rice-eclipse/rice-eclipse-mk1-1/README.md

# rice-eclipse-mk1-1
The official repository for mark 1.1 code and pcb schematics for the Rice Eclipse Rocketry Club at Rice University.
