rice-eclipse/rice-eclipse-mk1-1/(threads)

Thread 1 (2017-08-24):

Images For Wiki

rjcrjc, 2017-08-24:
This is an empty issue that contains images used in the wiki.

luke-avionics, 2017-09-16:
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

Ignition system

luke-avionics, 2017-09-16:
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

Ignition system (without alarm battery)

Closed 2017-09-02.

Thread 3 (2017-09-02):

Design Solenoid Driver

rjcrjc, 2017-09-02:
Build and test a circuit that switches on and off the solenoids for the ball valves. The output must be +12V and the inputs must have 3.3V logic level.  Get a breadboard setup and then add eagle files.
Suggest using mosfets or op amps.

rjcrjc, 2017-09-07:
@patrick-han is working on this

rjcrjc, 2017-09-09:
Circuit built and tested.

Closed 2017-09-09.

Thread 4 (2017-09-02):

Finish Power Regulation

rjcrjc, 2017-09-02:
Add regulators for +10V and -0.23V from the parts listed on the master parts list and then add them to the schematic.

I do not intend for this to be taken as a full project and I am using it mostly as a simple issue to test things for our github project management platform.

Closed 2017-12-17.

Thread 5 (2017-09-02):

Test and Implement Load Cell Amplification

rjcrjc, 2017-09-02:
We need to amplify data from the load cells from ~1-20mV to 3.3V in order to sample it.  This must have configurable gain and a configurable zero (using a screw/potentiometer that we could turn on the board). The op amps we will use are probably already selected and we have a test setup for them, but we need to verify it works with the load cell.

Level shifting circuitry may also be needed, which is annoying.

Once tested add it to the schematic on eagle.

rjcrjc, 2017-09-07:
There is a test board that works very well in the oedk right now. The downside is that it doesn't have any level shifting circuitry and I think we're running close to the amplification that we can reasonably use without doubling up op amps (we shouldn't aim for gain above 1500, which is what's currently on the board). If we get level shifting working, then we can gain a factor of 3 for amplification, which is probably about what we need. Let me know if you want me to walk you through what we currently have, because I can.

Closed 2017-10-16.

Thread 6 (2017-09-02):

Design Ignition Relay Driver

rjcrjc, 2017-09-02:
Similar to solenoid driver. We need to switch a +12V output from a 3.3V logic level pin on the raspberry pi.

Build a test circuit with the relay and then add to schematics.

rjcrjc, 2017-09-07:
@patrick-han is working on this

rjcrjc, 2017-09-09:
Test circuit built and tested.

Closed 2017-09-09.

Thread 11 (2017-09-03):

DMA for SPI driver on raspberry pi

rjcrjc, 2017-09-03:
It seems that most SPI libraries do not offer DMA. We need to fix this if we want good performance, look into whether any exist and test it. If not let me know and I will help look into other alternatives.

Thread 13 (2017-09-03):

Make Raspberry Pi act like Real Time Device

rjcrjc, 2017-09-03:
In general it is hard to make the raspberry pi act like it has a Real Time Operating System (RTOS), especially with common OS like Raspbian. It seems that there are some kernel options that may help this cause. In general we need to find a configuration that minimizes any interruptions from the operation of the system while still supporting networking, which we need to communicate with the base station computer.

I found [this link](http://www.frank-durr.de/?p=203) which may be of use.

I suspect this is a very difficult project and we may be better off switching away from the Raspberry pi in the long term instead of tackling this beast.

Thread 14 (2017-09-03):

Develop ADC test code

rjcrjc, 2017-09-03:
Build the ADC on a breadboard and test basic sampling to see if it works as expected.

Ideally this would include some functions we could run that would handle this and some pin definitions in a separate file to allow for portability later.

XtLiu, 2017-09-04:
I'll try to work on this part. Anyone interested is welcome to join me :)

Closed 2017-10-16.

Thread 16 (2017-09-03):

Figure out communication between pi and base station

rjcrjc, 2017-09-03:
Develop code for sending data between pi and base station.

This is some tricky networking code that may require running in its own thread. Contact me for advice because I think it will be difficult for anyone who hasn't taken Comp 321 or is willing to do a lot of research.

rjcrjc, 2017-09-08:
I got some basics working using socket and listener. Look at the echo_server branch and build target for examples. This basically covers reading bytes from the user, however it's unbuffered which means that it's going to be very slow. Whoever continues work on this should use buffered inputs.

Closed 2017-12-17.

Thread 7 (2017-09-03):

Figure out connectors for the PCB to the raspberry pi.

rjcrjc, 2017-09-03:
Find a connector we can use to connect the raspberry pi GPIO pins and other things to the PCB. I suggest using a ribbon cable for GPIO and for the other stuff, I'm not sure.

rjcrjc, 2017-09-07:
Got the GPIO connectors dealt with. Still need to add 2x20 thru hole connector to board + some screw holes for a holder for the idc cable. See parts list for details.

The other important thing is that power for the raspberry pi should be figured out. I think the best bet is just to take this from the mk2.

Closed 2017-09-14.

Thread 8 (2017-09-03):

Select Connectors for the Mk1-1 Box

rjcrjc, 2017-09-03:
Find connectors that we will plug into the exterior of the box. This is more of a long-term issue that doesn't directly correspond to code or work on the PCB, but it should be done.

Closed 2017-12-17.

Thread 9 (2017-09-03):

Ignition Current and Voltage Measurement

rjcrjc, 2017-09-03:
Design a system that tracks the current through and voltage across the igniter during ignition so that we can measure the electrical properties of the igniters.

This is a low-priority issue, worry about it later.

Thread 37 (2017-10-16):

Add support to ADC code for multiple ADCs.

rjcrjc, 2017-10-16:
## ToDo
- Currently the ADC code is set to always use chip select 0.
- This will not work for us because we would like to support 3+ ADCs and we only have two chip select pins on the pi.
- This means that we will need to manually control the chip select pins.
- Write a simple test example that switches between multiple ADCs. We don't need to actually connect ADCs to the pi to test this. I just want to see that the chip select pins change in accordance with the desired ADC.
- Verify this in particular with the dedicated chip select pins because it might be that we cannot control them independently and must do some extra work to deal with that.

## Useful Advice
- Take a look at the [SPI settings](http://www.airspayce.com/mikem/bcm2835/group__spi.html#ga2fa186568605c21e9166a19b1d82ea95) in the  [BCM2835](http://www.airspayce.com/mikem/bcm2835/) library header documentation.
- Also useful [list of constants](http://www.airspayce.com/mikem/bcm2835/group__constants.html) with some docs.
- Any constants we should be using should be passing to the adc should be of the type RPiGPIOPin and should be from the grouping RPI_V2_* because that's what our pi is (correct me if I'm wrong here)
- Take a look at the blink example on the library for controlling GPIO pins.
- It's possible that the pin state won't change immediately when you call the pin write function (unlikely, but I'm not sure. Check library docs to verify). Make sure that you don't do any SPI work until this happens.

rjcrjc, 2017-10-21:
[This](http://ww1.microchip.com/downloads/en/DeviceDoc/21298e.pdf) is the datasheet for the adc.

Closed 2017-12-17.

Thread 38 (2017-10-16):

Investigate ADC Drift and Noise

rjcrjc, 2017-10-16:
## Background
- The ADC test circuit on the breadboard is susceptible to noise and drift.
- It is significantly worse than performance promised in the [datasheet](http://ww1.microchip.com/downloads/en/DeviceDoc/21298e.pdf).
- Much of this is likely due to breadboard, but it's not clear how much.
- Most of the code to control the ADC already exists and is likely not at fault.

## ToDo
- Measure the voltage on the ADC pins using oscilloscope and see if it gives odd results when compared with the readings.
### Investigate the issues with drift.
- It's possible that the drift is coming from the ADC reading from high impedance values because most drift occurs when we switch what's connected to the pin. In this case we want to observe the issues in something more like our use case.
- Observe drift when switching which pin the adc is reading from (for instance read from each of the eight channels sequentially)
- Observe drift when all channels are connected to a low impedance input (like directly connected to +3.3V or GND).
- Is drift worse when we're using differential inputs?
### Investigate noise in the inputs:
- Variance, Max, Min value we read when conencted to an input like the potentiometer.
- Note that adc performs much better when reading from low impedance inputs. Try using an op amp follower circuit to see if this helps when using potentiometer.
- May be worth lowering the clock rate when reading to see if this also helps with noise.
    - [SPI clock rate](http://www.airspayce.com/mikem/bcm2835/group__spi.html#gad623657d9513faa89d22ae1dc87eec38) can be lowered by raising the clock divider in our [the adc block library](software/src/adc/adc_block.cpp)

## Useful Information
- You don't need to read entire datasheet. Skim it for things that look relevant.
- See if the datasheet mentions if clock rate affects noise.
- It's possible that some primitive antialiasing will improve performance (like a 10K resistor in series with a 10nF capacitor between the input channel and ground for single channel inputs (intuitively this acts like a RC filter with a cutoff of 10kHz). For dual channel the RC goes between the two inputs and is not connected to ground.
- If you have a ton of extra time, it might be interesting to try soldering the extra ADC we have in the Digital ICs drawer to a simple custom PCB and see if the noise problems go away.
- It's very possible that only the ground input has major issues when reading. If that's the case you don't necessarily need to solve it. But it's worth checking if an op amp that's outputting ~0V has the same problem.

Thread 49 (2017-12-17):

Gracefully handle error when PI server cannot send header instead of terminating.

rjcrjc, 2017-12-17:
If the socket breaks during a header write the server code terminates. We must fix this.

Thread 50 (2017-12-17):

Determine why GUI message length assertion errors are getting triggered

rjcrjc, 2017-12-17:
Two possible causes:
* the actual message size sent by the PI are the wrong length, which could happen if a message splits across the circular buffer.
    * This can be tested by downsizing circular buffer and seeing if it happens more often.
* The GUI is getting short reads and not handling the short reads correctly.
    * Best way to test this is to have some assertion that we're not having short reads.

Both of these might be best resolved by switching the message sending to UDP, but we should still figure out why this is failing with TCP.

Thread 51 (2017-12-17):

Add High Pressure Shutoff for Ignition in RPI Code.

rjcrjc, 2017-12-17:
Add code to check that the pressure is not too high in the combustion chamber (? Ask, since it might be a different PT we need to read) and if the pressure is too high, then terminate the burn.

Note that we do not have support for actual pressure values at the moment, so for now: have a value that is hardcoded and we'll figure out a way to properly evaluate the pressure later.

Ideally, this will use a moving average of the pressure data to remove high frequency noise.

Thread 52 (2017-12-17):

Add Logging of Collected Data to Raspberry PI

rjcrjc, 2017-12-17:
Create Log files for each ADC and write the data to logs so that the data collection is more resilient to GUI crashes.

Thread 53 (2017-12-17):

Improve the look of the GUI

rjcrjc, 2017-12-17:
The final changes to the GUI were made with no understanding of Tkinter and the GUI looks terrible. Make the GUI usable and also make the positions somewhat dependent on the size of the window. That is, the buttons should still show up even if the window is resized to be relatively small.

Ideally, we would also have tabs for different data displays.

ty19, 2017-12-22:
The GUI (pushed to final-code-c) looks nicer now, imo. The right panel is ugly because it's mostly empty, but we can always add things later. I set the window to be non-resizable, which I consider a fix to the window size issue.

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
 It seems like there's a built-in way to do tabs, but I'm not sure what I would put in each one. We could do something like default (important ones we look at during tests), LCs, PTs, TCs for each tab. Do you have something specific in mind?

rjcrjc, 2017-12-24:
I did not have anything specific in mind for tabs, but I have a couple things that should probably go in their own tabs: Namely a tab for any output from the loggers. I would also have a tab for each sensor that includes calibration and some data such as an average over last 10 seconds.

I suppose the window resizing fix is probably the easiest thing without a lot of tkinter work that isn't really a good use of our time.

Thread 54 (2017-12-17):

Fix real-time graphing.

rjcrjc, 2017-12-17:
The graphs on the GUI do not discard old data and they also display the data with all data-points. Furthermore, they do not look good with noisy data.

The graphs should have the following two properties:
* Ability to display a specified range of time (say 10 seconds, 1 minute etc.)
    * For large times like a minute or more, the graphing code will need to downsample the data in order to avoid plotting too many points. Contact me for help with proper downsampling and decimation.
* Option for denoised plots. Again contact me or look at the analytics.m script I posted in the google drive for how to clean up the noise.

ty19, 2017-12-22:
I added a basic way to change time ranges. I guess time would just be total_samples / samples_per_time if we put the sample rate of each sensor somewhere in the code. I can add buttons and stuff so we can change the time ranges during tests. Not sure on how to downsample other than by throwing out every nth data point in the data we're plotting.

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

Is there any reason denoised plots would not be the default option?

rjcrjc, 2017-12-24:
Nice work on this stuff! I can help with proper denoising and downsampling later since it's not really in the realm of CS knowledge, but for now just throwing out points is good enough for the real-time plots.

Thread 56 (2017-12-17):

Improve the python translation of C Structs.

rjcrjc, 2017-12-17:
The python code currently uses hardcoded sizes to read from C structs, which is bad because it is tedious and error-prone when writing. There are libraries for translating sizes from c structs, which is what we need when sending the data formatted using C Structs.

Thread 57 (2017-12-17):

Make Code Resilient to Crashes

rjcrjc, 2017-12-17:
When the raspberry pi code crashes, the code should be restarted immediately to resume logging.

The easiest way to do this is to run the server through a shell script that restarts when the PI returns and terminates if killed manually or maybe if the PI code returns a specific value.

While this is not a good solution to crashes, it does mean that less data is missed if the code does crash.

Thread 58 (2017-12-17):

Figure out what is wrong with the Pressure Transducer circuits

rjcrjc, 2017-12-17:
The pressure transducer circuits do not read properly in the range of 0 to 1200PSI at the moment. There are several main causes right now:
* We changed the gain resistor in line with the pressure transducer to fix the issue the night before the test.
* The gain on the circuits themselves is wrong and slightly inconsistent.

* Maybe:
    * The bypass capicitor on the op amps is too small.
    * The circuit was designed with wrong parameters measured because the PT is senstitive to installation method.
### To consider:
* At the moment two of the circuits behave differently from the leftmost one. Not sure why.
* Increase sample rate and verify readings are still fine (probably easy).
* Note that doing this well will probably require pulling the board out, which sucks.
