rice-eclipse/rice-eclipse-mk1-1/eagle/rice-eclipse-mk-1-1-side/rice-eclipse-mk-1-1-side/sideboard.brd

## EAGLE design eagle/rice-eclipse-mk-1-1-side/rice-eclipse-mk-1-1-side/sideboard.brd (2018-01-20)

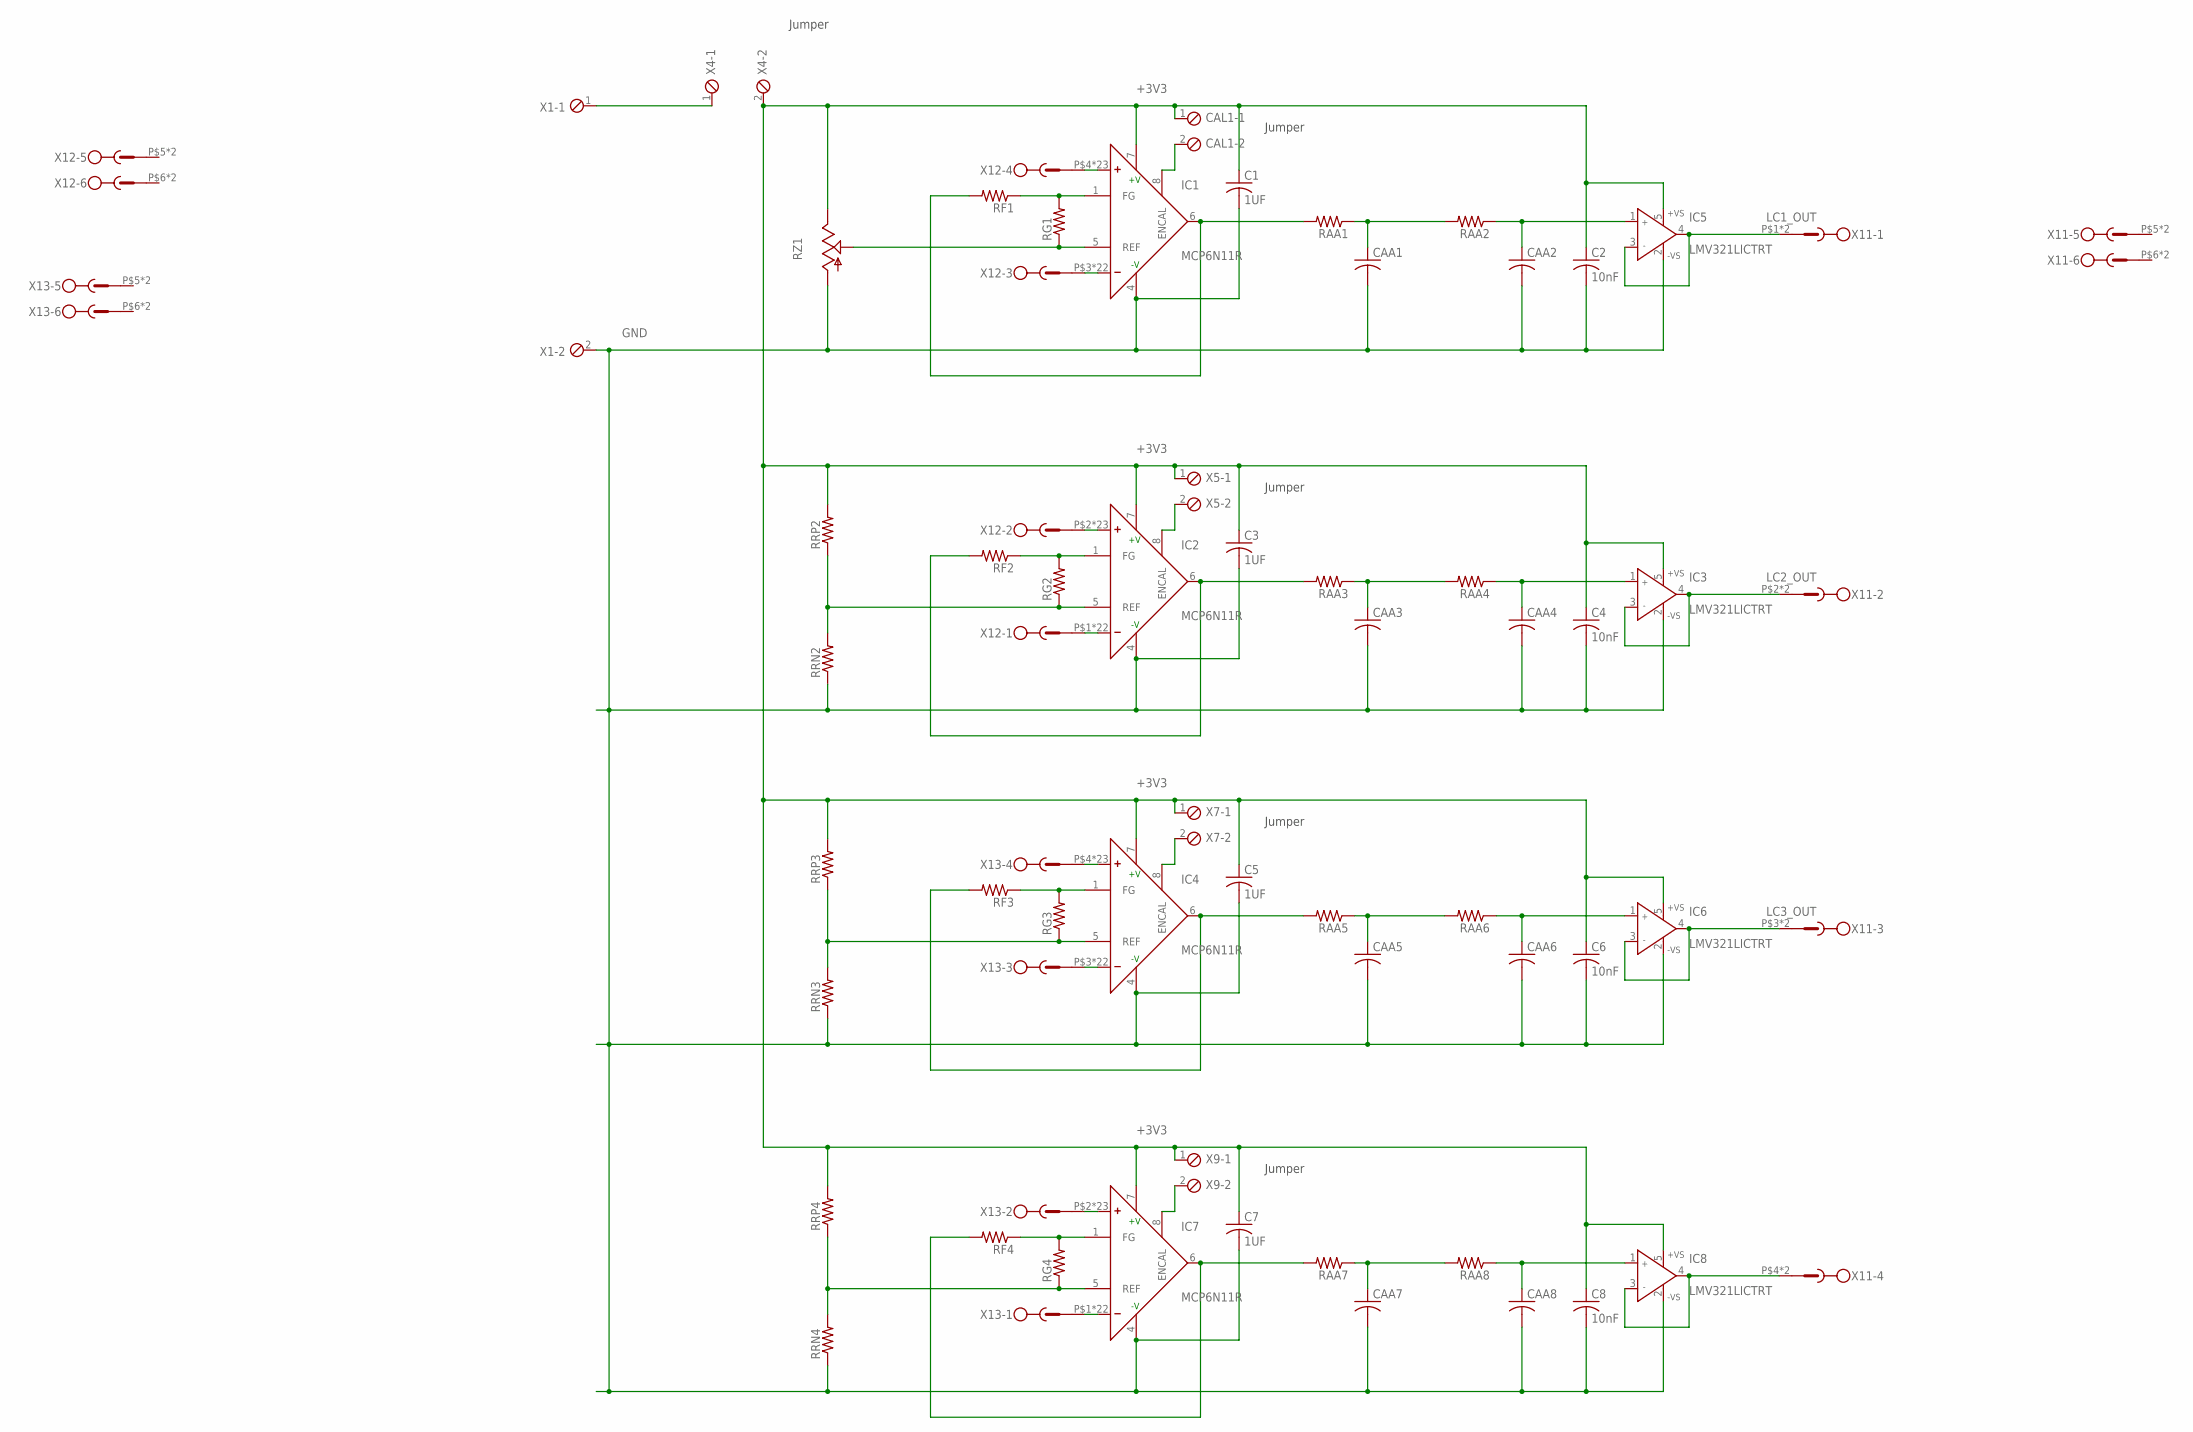
[picture p1: schematic sideboard.sch, <b>LC Sideboard</b><br> A small board used to amplify and t…]

Parts:
C1, C3, C5, C7: 1UF; C0603
C2, C4, C6, C8: 10nF; C0603
CAA1, CAA2, CAA3, CAA4, CAA5, CAA6, CAA7, CAA8: C-US025-025X050; C025-025X050
CAL1: MPT2; 2POL254
IC1, IC2, IC4, IC7: MCP6N11R; SO-8
IC3, IC5, IC6, IC8: LMV321LICTRT; SOT23-5
RAA1, RAA2, RAA3, RAA4, RAA5, RAA6, RAA7, RAA8: R-US_0204/7; 0204/7
RF1, RF2, RF3, RF4: R-US_0204/7; 0204/7
RG1, RG2, RG3, RG4: R-US_0204/7; 0204/7
RRN2, RRN3, RRN4: R-US_R0805; R0805
RRP2, RRP3, RRP4: R-US_R0805; R0805
RZ1: TRIM_US-S64W; S64W
X1, X4, X5, X7, X9: MPT2; 2POL254
X11, X12, X13: 1770924

Connections:
+3V3: C1.1, C2.1, C3.1, C4.1, C5.1, C6.1, C7.1, C8.1, CAL1.1, IC1.7 (+V), IC2.7 (+V), IC3.5 (+VS), IC4.7 (+V), IC5.5 (+VS), IC6.5 (+VS), IC7.7 (+V), IC8.5 (+VS), RRP2.2, RRP3.2, RRP4.2, RZ1.E, X4.2, X5.1, X7.1, X9.1
GND: C1.2, C2.2, C3.2, C4.2, C5.2, C6.2, C7.2, C8.2, CAA1.2, CAA2.2, CAA3.2, CAA4.2, CAA5.2, CAA6.2, CAA7.2, CAA8.2, IC1.4 (-V), IC2.4 (-V), IC3.2 (-VS), IC4.4 (-V), IC5.2 (-VS), IC6.2 (-VS), IC7.4 (-V), IC8.2 (-VS), RRN2.1, RRN3.1, RRN4.1, RZ1.A, X1.2
LC1_OUT: IC5.3 (IN-), IC5.4 (OUT), X11.P$1, X11.P$7
LC2_OUT: IC3.3 (IN-), IC3.4 (OUT), X11.P$2, X11.P$8
LC3_OUT: IC6.3 (IN-), IC6.4 (OUT), X11.P$3, X11.P$9
LC4_OUT1: IC8.3 (IN-), IC8.4 (OUT), X11.P$4, X11.P$10
unnamed: IC2.3 (+), X12.P$2, X12.P$8
unnamed: IC2.2 (-), X12.P$1, X12.P$7
unnamed: X1.1, X4.1
unnamed: IC1.6 (OUT), RAA1.2, RF1.2
unnamed: CAL1.2, IC1.8 (ENCAL)
unnamed: CAA1.1, RAA1.1, RAA2.2
unnamed: IC1.1 (FG), RF1.1, RG1.2
unnamed: IC1.5 (REF), RG1.1, RZ1.S
unnamed: CAA2.1, IC5.1 (IN+), RAA2.1
unnamed: IC1.2 (-), X12.P$3, X12.P$9
unnamed: IC1.3 (+), X12.P$4, X12.P$10
unnamed: IC2.8 (ENCAL), X5.2
unnamed: IC2.6 (OUT), RAA3.2, RF2.2
unnamed: IC2.1 (FG), RF2.1, RG2.2
unnamed: CAA3.1, RAA3.1, RAA4.2
unnamed: CAA4.1, IC3.1 (IN+), RAA4.1
unnamed: IC2.5 (REF), RG2.1, RRN2.2, RRP2.1
unnamed: IC7.2 (-), X13.P$1, X13.P$7
unnamed: IC7.3 (+), X13.P$2, X13.P$8
unnamed: IC4.8 (ENCAL), X7.2
unnamed: IC4.6 (OUT), RAA5.2, RF3.2
unnamed: IC4.1 (FG), RF3.1, RG3.2
unnamed: CAA5.1, RAA5.1, RAA6.2
unnamed: CAA6.1, IC6.1 (IN+), RAA6.1
unnamed: IC4.5 (REF), RG3.1, RRN3.2, RRP3.1
unnamed: IC4.3 (+), X13.P$4, X13.P$10
unnamed: IC4.2 (-), X13.P$3, X13.P$9
unnamed: IC7.8 (ENCAL), X9.2
unnamed: IC7.6 (OUT), RAA7.2, RF4.2
unnamed: IC7.1 (FG), RF4.1, RG4.2
unnamed: CAA7.1, RAA7.1, RAA8.2
unnamed: CAA8.1, IC8.1 (IN+), RAA8.1
unnamed: IC7.5 (REF), RG4.1, RRN4.2, RRP4.1

Notes on the sheet:
Jumper

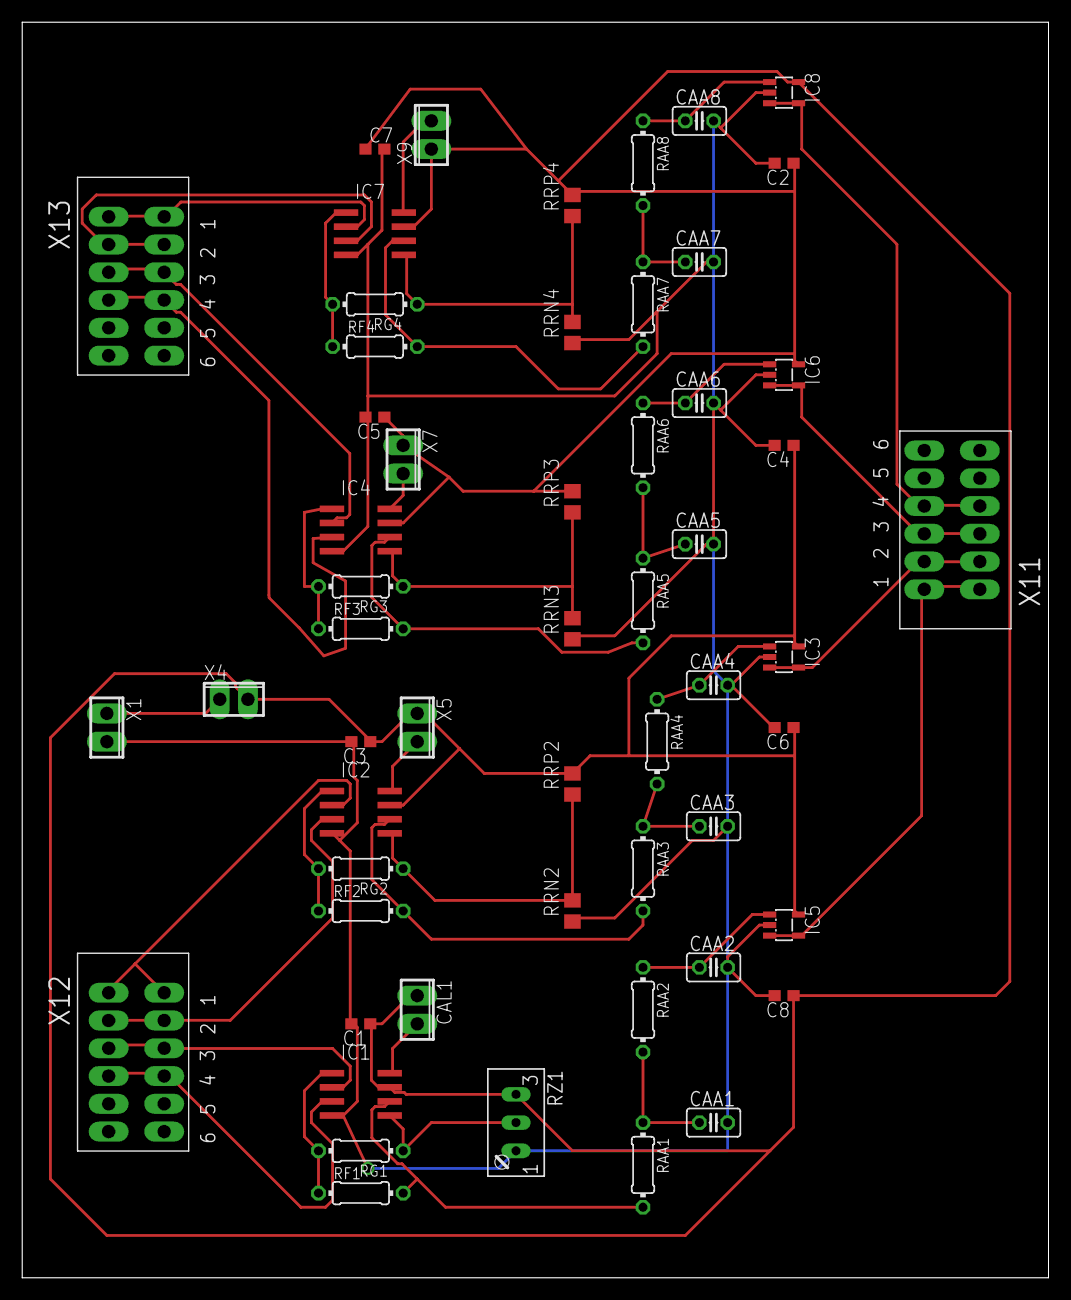
[picture p2: board sideboard.brd from above]

Board: 2 copper layers, 92.4 x 113.0 mm, 56 parts (0 on the bottom side), 39 nets.
