rice-eclipse/rice-eclipse-mk1-1/eagle/rice-eclipse-mk-1-1/main.brd

## EAGLE design eagle/rice-eclipse-mk-1-1/main.brd (2017-11-11)

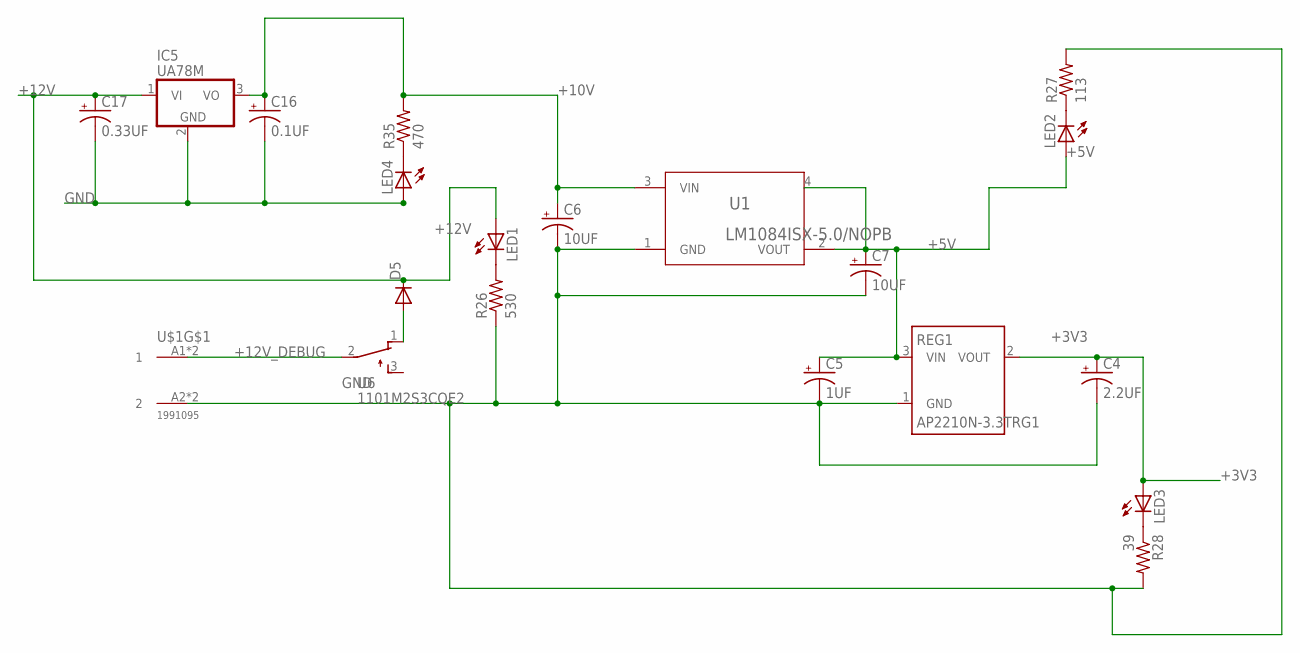
[picture p3: schematic main.sch, sheet 1, <b>Power Regulation</b><br> A sheet for all the voltage reg…]

Parts:
C4: 2.2UF; E2,5-5
C5: 1UF; E2,5-5
C6, C7: 10UF; E2,5-5
C16: 0.1UF; E2,5-5
C17: 0.33UF; E2,5-5
D5: DIODE-DO201-15; DO201-15
IC5: UA78M; TO220S
LED1, LED2, LED3, LED4: LED5MM
R26: 530; R0603
R27: 113; R0603
R28: 39; R0603
R35: 470; R0603
REG1: AP2210N-3.3TRG1; SOT23
U1: LM1084ISX-5.0/NOPB; TS3B
U6: 1101M2S3CQE2
U$1: 1991095

Connections:
+3V3: C4.+, LED3.A, REG1.2 (VOUT); also elsewhere on the board
+5V: C5.+, C7.+, LED2.A, REG1.3 (VIN), U1.2 (VOUT), U1.4; also elsewhere on the board
+10V: C6.+, C16.+, IC5.3 (VO), R35.2, U1.3 (VIN); also elsewhere on the board
+12V: C17.+, D5.C, IC5.1 (VI), LED1.A; also elsewhere on the board
+12V_DEBUG: U6.2, U$1.A1 (1), U$1.B1 (1)
GND: C4.-, C5.-, C6.-, C7.-, C16.-, C17.-, IC5.2 (GND), LED4.A, R26.1, R27.2, R28.2, REG1.1 (GND), U1.1 (GND), U$1.A2 (2), U$1.B2 (2); also elsewhere on the board
unnamed: LED1.K (C), R26.2
unnamed: LED2.K (C), R27.1
unnamed: LED3.K (C), R28.1
unnamed: D5.A, U6.1 (O)
unnamed: LED4.K (C), R35.1

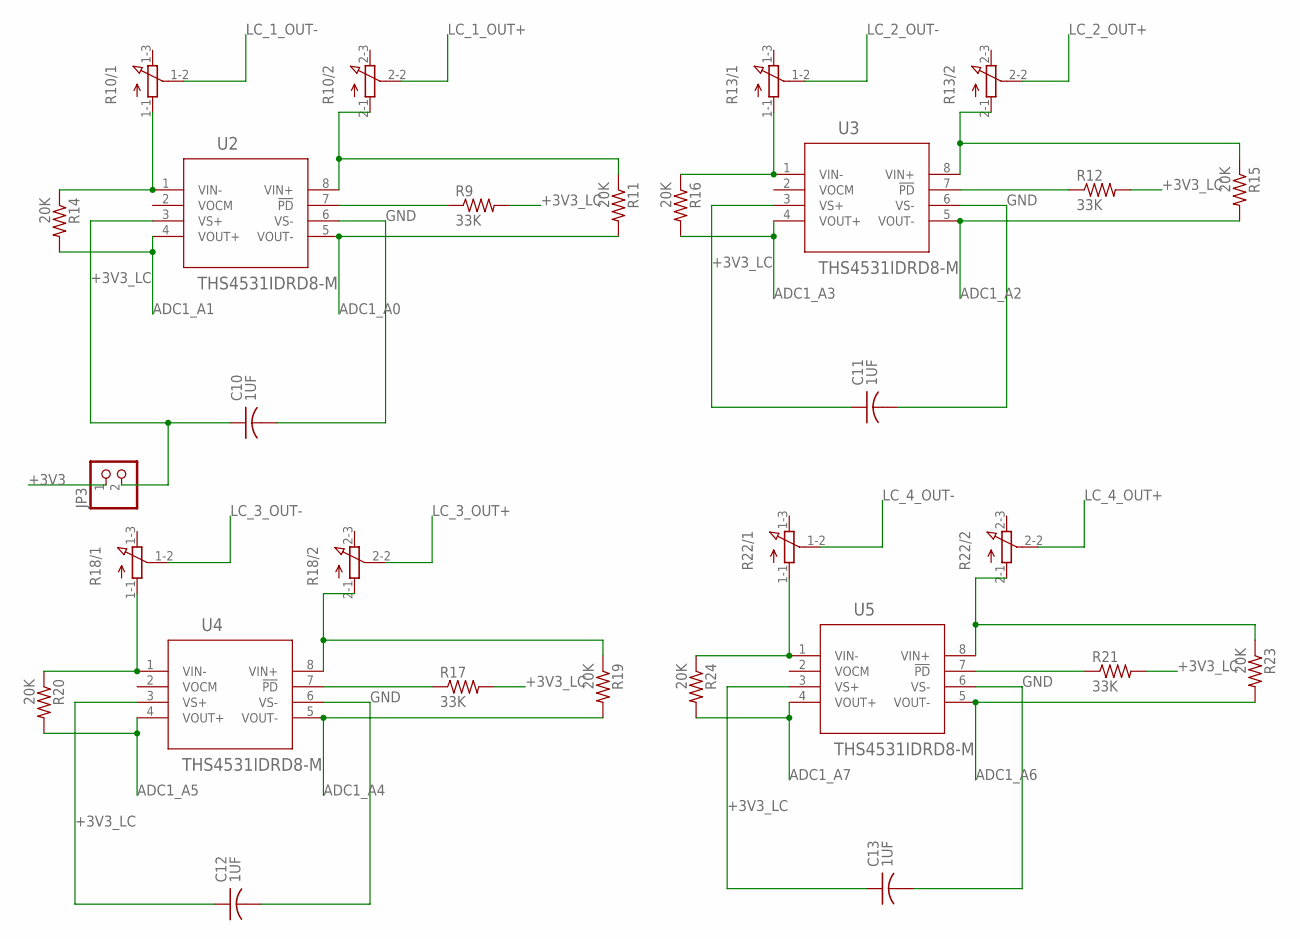
[picture p4: schematic main.sch, sheet 2, <b>Load Cell Amplification</b><br> A schematic for amplifyi…]

Parts:
C10, C11, C12, C13: 1UF; C0603
JP3: PINHD-1X2; 1X02
R9, R12, R17, R21: 33K; R0603
R10, R13, R18, R22: PTD902
R11, R14, R15, R16, R19, R20, R23, R24: 20K; R0603
U2, U3, U4, U5: THS4531IDRD8-M; D8-M

Connections:
+3V3: JP3.1; also elsewhere on the board
+3V3_LC: C10.1, C11.1, C12.1, C13.1, JP3.2, R9.2, R12.2, R17.2, R21.2, U2.3 (VS+), U3.3 (VS+), U4.3 (VS+), U5.3 (VS+)
ADC1_A0: R11.2, U2.5 (VOUT-); also elsewhere on the board
ADC1_A1: R14.2, U2.4 (VOUT+); also elsewhere on the board
ADC1_A2: R15.2, U3.5 (VOUT-); also elsewhere on the board
ADC1_A3: R16.2, U3.4 (VOUT+); also elsewhere on the board
ADC1_A4: R19.2, U4.5 (VOUT-); also elsewhere on the board
ADC1_A5: R20.2, U4.4 (VOUT+); also elsewhere on the board
ADC1_A6: R23.2, U5.5 (VOUT-); also elsewhere on the board
ADC1_A7: R24.2, U5.4 (VOUT+); also elsewhere on the board
GND: C10.2, C11.2, C12.2, C13.2, U2.6 (VS-), U3.6 (VS-), U4.6 (VS-), U5.6 (VS-); also elsewhere on the board
LC_1_OUT+: R10.2-2 (S); also elsewhere on the board
LC_1_OUT-: R10.1-2 (S); also elsewhere on the board
LC_2_OUT+: R13.2-2 (S); also elsewhere on the board
LC_2_OUT-: R13.1-2 (S); also elsewhere on the board
LC_3_OUT+: R18.2-2 (S); also elsewhere on the board
LC_3_OUT-: R18.1-2 (S); also elsewhere on the board
LC_4_OUT+: R22.2-2 (S); also elsewhere on the board
LC_4_OUT-: R22.1-2 (S); also elsewhere on the board
unnamed: R9.1, U2.7 (!PD)
unnamed: R10.2-1 (A), R11.1, U2.8 (VIN+)
unnamed: R12.1, U3.7 (!PD)
unnamed: R13.2-1 (A), R15.1, U3.8 (VIN+)
unnamed: R10.1-1 (A), R14.1, U2.1 (VIN-)
unnamed: R13.1-1 (A), R16.1, U3.1 (VIN-)
unnamed: R17.1, U4.7 (!PD)
unnamed: R18.2-1 (A), R19.1, U4.8 (VIN+)
unnamed: R18.1-1 (A), R20.1, U4.1 (VIN-)
unnamed: R21.1, U5.7 (!PD)
unnamed: R22.2-1 (A), R23.1, U5.8 (VIN+)
unnamed: R22.1-1 (A), R24.1, U5.1 (VIN-)

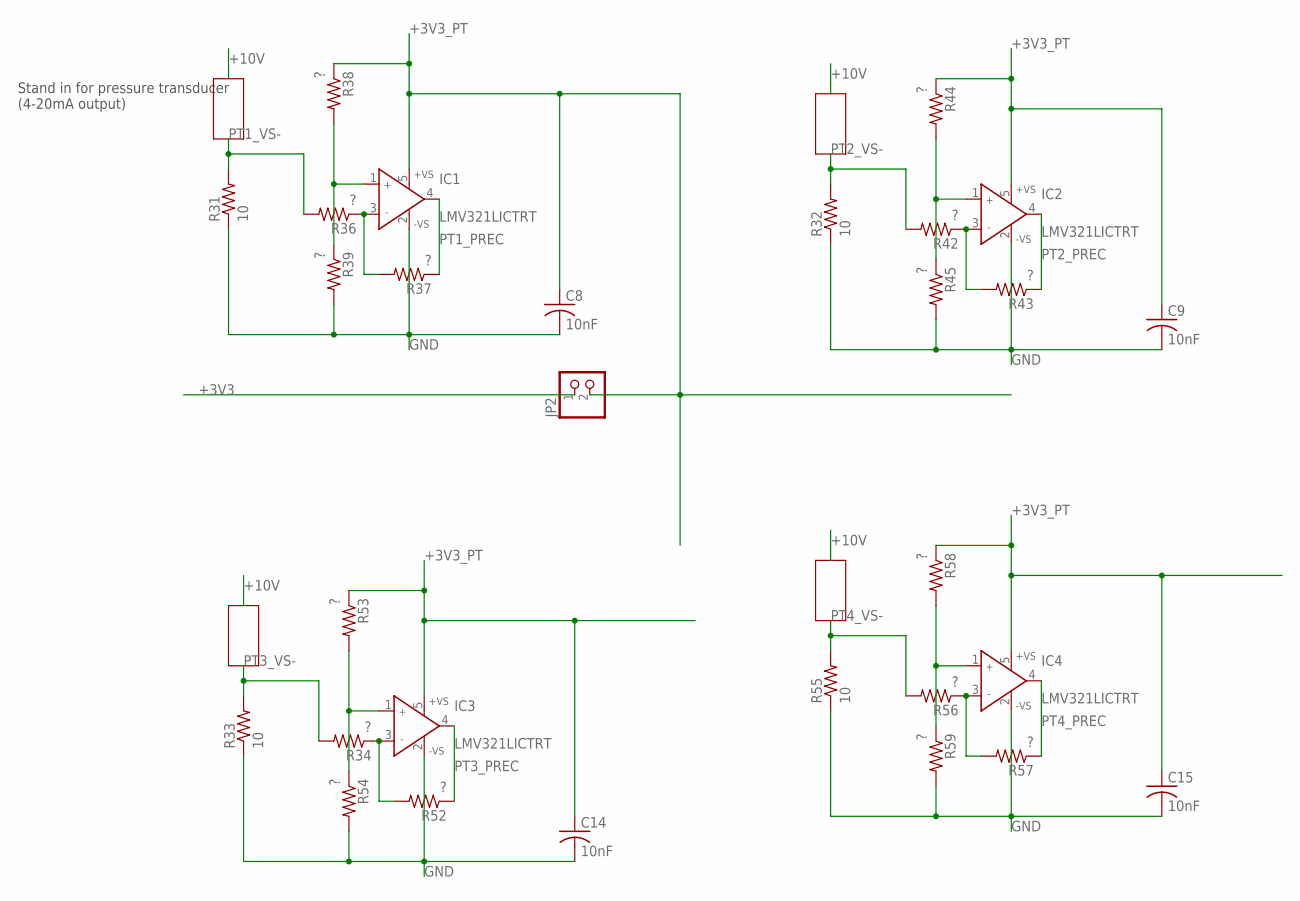
[picture p5: schematic main.sch, sheet 3, <b>PT Amplification</b><br> Circuits for measuring PT]

Parts:
C8, C9, C14, C15: 10nF; C0402K
IC1, IC2, IC3, IC4: LMV321LICTRT; SOT23-5
JP2: PINHD-1X2; 1X02
R31, R32, R33, R55: 10; R0603
R34, R36, R37, R38, R39, R42, R43, R44, R45, R52, R53, R54, R56, R57, R58, R59: ?; 0204/7

Connections:
+3V3: JP2.1; also elsewhere on the board
+3V3_PT: C8.1, C9.1, C14.1, C15.1, IC1.5 (+VS), IC2.5 (+VS), IC3.5 (+VS), IC4.5 (+VS), JP2.2, R38.1, R44.1, R53.1, R58.1; also elsewhere on the board
GND: C8.2, C9.2, C14.2, C15.2, IC1.2 (-VS), IC2.2 (-VS), IC3.2 (-VS), IC4.2 (-VS), R31.1, R32.1, R33.1, R39.2, R45.2, R54.2, R55.1, R59.2; also elsewhere on the board
unnamed: IC1.3 (IN-), R36.1, R37.2
unnamed: IC1.1 (IN+), R38.2, R39.1
unnamed: IC2.3 (IN-), R42.1, R43.2
unnamed: IC2.1 (IN+), R44.2, R45.1
unnamed: IC3.3 (IN-), R34.1, R52.2
unnamed: IC3.1 (IN+), R53.2, R54.1
unnamed: IC4.3 (IN-), R56.1, R57.2
unnamed: IC4.1 (IN+), R58.2, R59.1
PT1_PREC: IC1.4 (OUT), R37.1; also elsewhere on the board
PT1_VS-: R31.2, R36.2; also elsewhere on the board
PT2_PREC: IC2.4 (OUT), R43.1; also elsewhere on the board
PT2_VS-: R32.2, R42.2; also elsewhere on the board
PT3_PREC: IC3.4 (OUT), R52.1; also elsewhere on the board
PT3_VS-: R33.2, R34.2; also elsewhere on the board
PT4_PREC: IC4.4 (OUT), R57.1; also elsewhere on the board
PT4_VS-: R55.2, R56.2; also elsewhere on the board

Notes on the sheet:
Stand in for pressure transducer (4-20mA output)

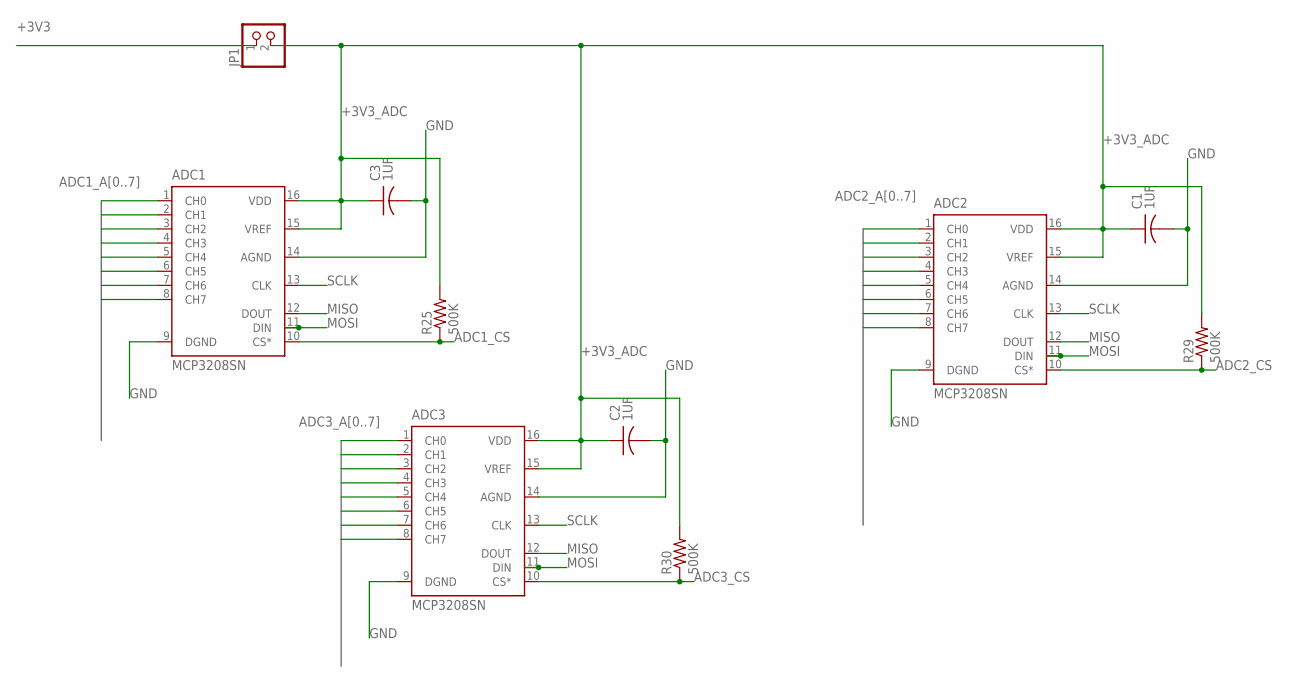
[picture p6: schematic main.sch, sheet 4, <title>ADC</title> The updated schematic for the adc becaus…]

Parts:
ADC1, ADC2, ADC3: MCP3208SN; SO-16
C1, C2, C3: 1UF; C0603
JP1: PINHD-1X2; 1X02
R25, R29, R30: 500K; R0603

Connections:
+3V3: JP1.1; also elsewhere on the board
+3V3_ADC: ADC1.15 (VREF), ADC1.16 (VDD), ADC2.15 (VREF), ADC2.16 (VDD), ADC3.15 (VREF), ADC3.16 (VDD), C1.1, C2.1, C3.1, JP1.2, R25.2, R29.2, R30.2
ADC1_A0: ADC1.1 (CH0); also elsewhere on the board
ADC1_A1: ADC1.2 (CH1); also elsewhere on the board
ADC1_A2: ADC1.3 (CH2); also elsewhere on the board
ADC1_A3: ADC1.4 (CH3); also elsewhere on the board
ADC1_A4: ADC1.5 (CH4); also elsewhere on the board
ADC1_A5: ADC1.6 (CH5); also elsewhere on the board
ADC1_A6: ADC1.7 (CH6); also elsewhere on the board
ADC1_A7: ADC1.8 (CH7); also elsewhere on the board
ADC1_CS: ADC1.10 (CS*), R25.1; also elsewhere on the board
ADC2_A0: ADC2.1 (CH0); also elsewhere on the board
ADC2_A1: ADC2.2 (CH1); also elsewhere on the board
ADC2_A2: ADC2.3 (CH2); also elsewhere on the board
ADC2_A3: ADC2.4 (CH3); also elsewhere on the board
ADC2_A4: ADC2.5 (CH4); also elsewhere on the board
ADC2_A5: ADC2.6 (CH5); also elsewhere on the board
ADC2_A6: ADC2.7 (CH6); also elsewhere on the board
ADC2_A7: ADC2.8 (CH7); also elsewhere on the board
ADC2_CS: ADC2.10 (CS*), R29.1; also elsewhere on the board
ADC3_A0: ADC3.1 (CH0); also elsewhere on the board
ADC3_A1: ADC3.2 (CH1); also elsewhere on the board
ADC3_A2: ADC3.3 (CH2); also elsewhere on the board
ADC3_A3: ADC3.4 (CH3); also elsewhere on the board
ADC3_A4: ADC3.5 (CH4); also elsewhere on the board
ADC3_A5: ADC3.6 (CH5); also elsewhere on the board
ADC3_A6: ADC3.7 (CH6); also elsewhere on the board
ADC3_A7: ADC3.8 (CH7); also elsewhere on the board
ADC3_CS: ADC3.10 (CS*), R30.1; also elsewhere on the board
GND: ADC1.9 (DGND), ADC1.14 (AGND), ADC2.9 (DGND), ADC2.14 (AGND), ADC3.9 (DGND), ADC3.14 (AGND), C1.2, C2.2, C3.2; also elsewhere on the board
MISO: ADC1.12 (DOUT), ADC2.12 (DOUT), ADC3.12 (DOUT); also elsewhere on the board
MOSI: ADC1.11 (DIN), ADC2.11 (DIN), ADC3.11 (DIN); also elsewhere on the board
SCLK: ADC1.13 (CLK), ADC2.13 (CLK), ADC3.13 (CLK); also elsewhere on the board

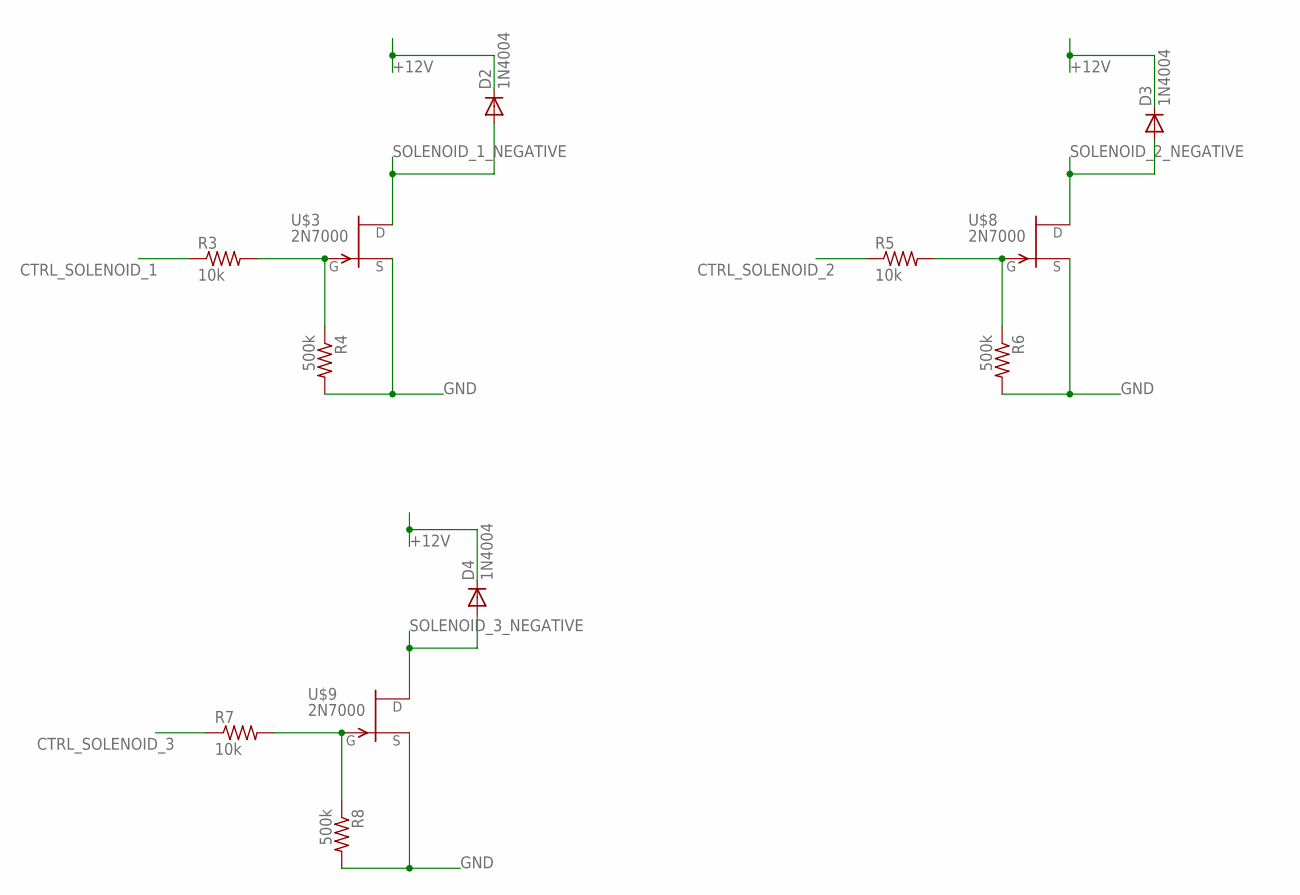
[picture p7: schematic main.sch, sheet 5, <b>Solenoid Driver</b><br> A circuit that controls the driv…]

Parts:
D2, D3, D4: 1N4004; DO41-10
R3, R5, R7: 10k; R0603
R4, R6, R8: 500k; R0603
U$3, U$8, U$9: 2N7000; SOT23

Connections:
+12V: D2.C, D3.C, D4.C; also elsewhere on the board
CTRL_SOLENOID_1: R3.1; also elsewhere on the board
CTRL_SOLENOID_2: R5.1; also elsewhere on the board
CTRL_SOLENOID_3: R7.1; also elsewhere on the board
GND: R4.2, R6.2, R8.2, U$3.2 (S), U$8.2 (S), U$9.2 (S); also elsewhere on the board
unnamed: R3.2, R4.1, U$3.1 (G)
unnamed: R5.2, R6.1, U$8.1 (G)
unnamed: R7.2, R8.1, U$9.1 (G)
SOLENOID_1_NEGATIVE: D2.A, U$3.3 (D); also elsewhere on the board
SOLENOID_2_NEGATIVE: D3.A, U$8.3 (D); also elsewhere on the board
SOLENOID_3_NEGATIVE: D4.A, U$9.3 (D); also elsewhere on the board

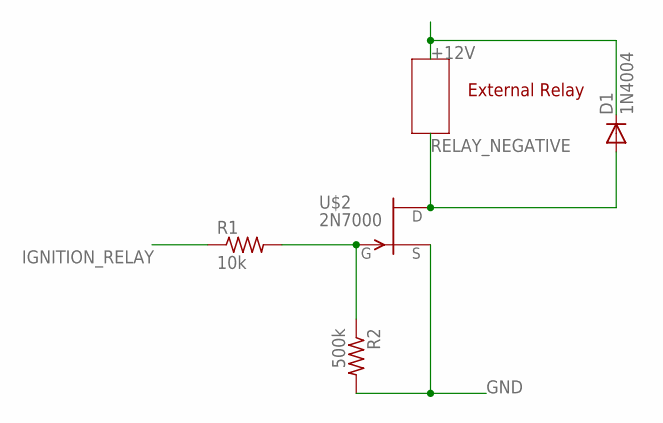
[picture p8: schematic main.sch, sheet 6, <b>Ignition Driver</b><br> A circuit that controls the rela…]

Parts:
D1: 1N4004; DO41-10
R1: 10k; R0603
R2: 500k; R0603
U$2: 2N7000; SOT23

Connections:
+12V: D1.C; also elsewhere on the board
GND: R2.2, U$2.2 (S); also elsewhere on the board
IGNITION_RELAY: R1.1; also elsewhere on the board
unnamed: R1.2, R2.1, U$2.1 (G)
RELAY_NEGATIVE: D1.A, U$2.3 (D); also elsewhere on the board

Notes on the sheet:
External Relay

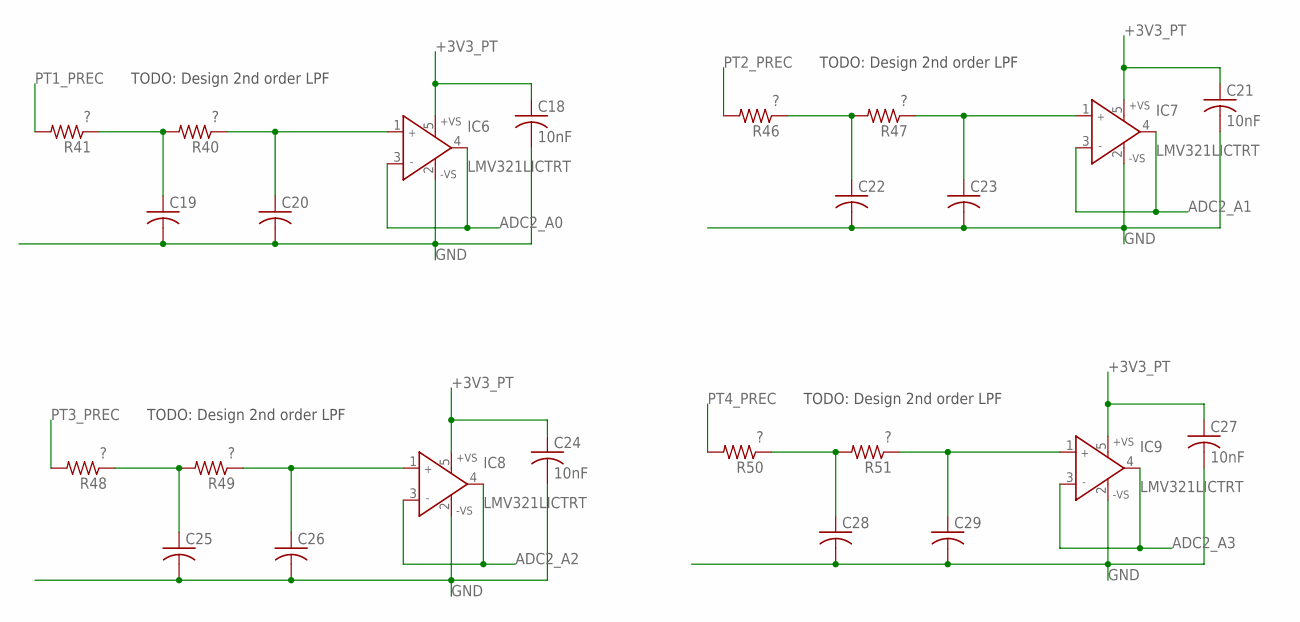
[picture p9: schematic main.sch, sheet 7, <b>Anti-Aliasing</b><br> Circuits used for anti-aliasing al…]

Parts:
C18, C21, C24, C27: 10nF; C0402K
C19, C20, C22, C23, C25, C26, C28, C29: C-US025-025X050; C025-025X050
IC6, IC7, IC8, IC9: LMV321LICTRT; SOT23-5
R40, R41, R46, R47, R48, R49, R50, R51: ?; 0204/7

Connections:
+3V3_PT: C18.1, C21.1, C24.1, C27.1, IC6.5 (+VS), IC7.5 (+VS), IC8.5 (+VS), IC9.5 (+VS); also elsewhere on the board
ADC2_A0: IC6.3 (IN-), IC6.4 (OUT); also elsewhere on the board
ADC2_A1: IC7.3 (IN-), IC7.4 (OUT); also elsewhere on the board
ADC2_A2: IC8.3 (IN-), IC8.4 (OUT); also elsewhere on the board
ADC2_A3: IC9.3 (IN-), IC9.4 (OUT); also elsewhere on the board
GND: C18.2, C19.2, C20.2, C21.2, C22.2, C23.2, C24.2, C25.2, C26.2, C27.2, C28.2, C29.2, IC6.2 (-VS), IC7.2 (-VS), IC8.2 (-VS), IC9.2 (-VS); also elsewhere on the board
unnamed: C19.1, R40.2, R41.1
unnamed: C20.1, IC6.1 (IN+), R40.1
unnamed: C22.1, R46.1, R47.2
unnamed: C23.1, IC7.1 (IN+), R47.1
unnamed: C25.1, R48.1, R49.2
unnamed: C26.1, IC8.1 (IN+), R49.1
unnamed: C28.1, R50.1, R51.2
unnamed: C29.1, IC9.1 (IN+), R51.1
PT1_PREC: R41.2; also elsewhere on the board
PT2_PREC: R46.2; also elsewhere on the board
PT3_PREC: R48.2; also elsewhere on the board
PT4_PREC: R50.2; also elsewhere on the board

Notes on the sheet:
TODO: Design 2nd order LPF

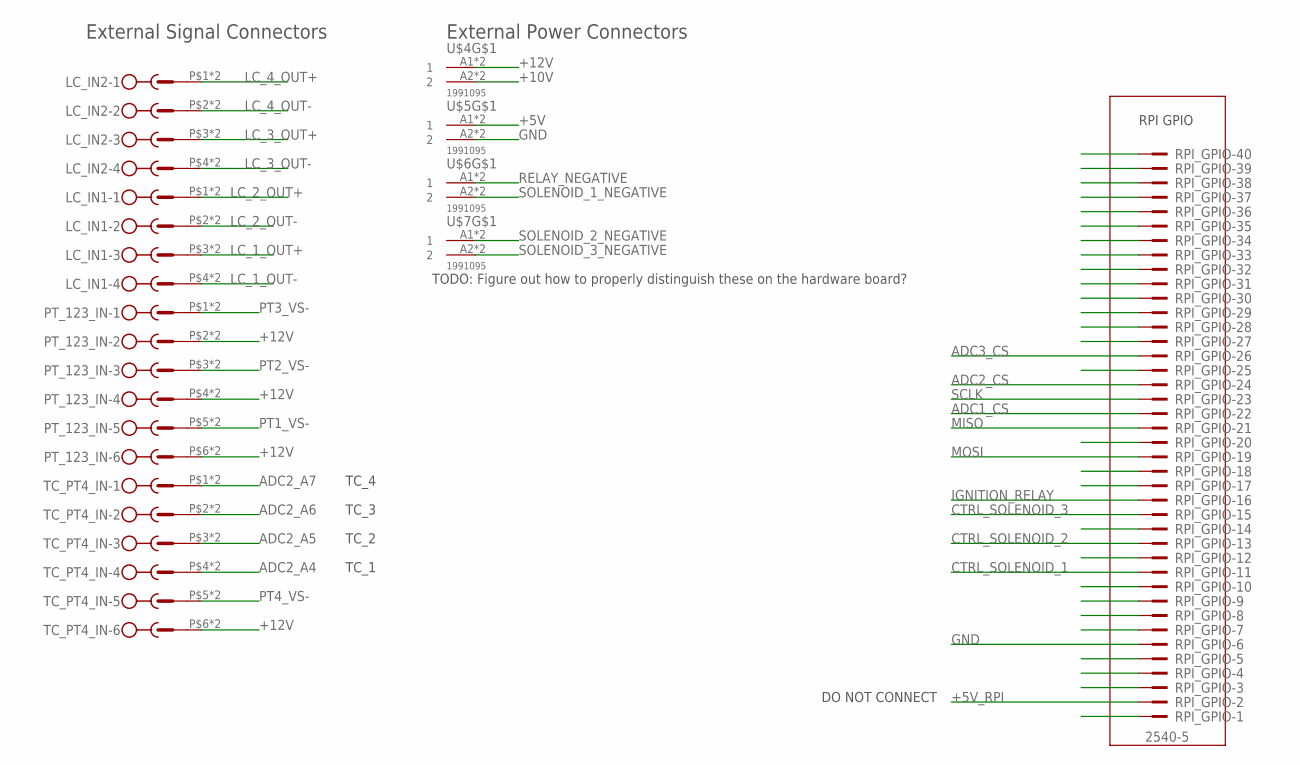
[picture p10: schematic main.sch, sheet 8, <b>External Connectors<\b><br> All the external connectors …]

Parts:
LC_IN1, LC_IN2: 1770908
PT_123_IN: 1770924
RPI_GPIO: 2540-5; PAK100/2500-5-40
TC_PT4_IN: 1770924
U$4, U$5, U$6, U$7: 1991095

Connections:
+5V: U$5.A1 (1), U$5.B1 (1); also elsewhere on the board
+5V_RPI: RPI_GPIO.2
+10V: U$4.A2 (2), U$4.B2 (2); also elsewhere on the board
+12V: PT_123_IN.P$2, PT_123_IN.P$4, PT_123_IN.P$6, PT_123_IN.P$8, PT_123_IN.P$10, PT_123_IN.P$12, TC_PT4_IN.P$6, TC_PT4_IN.P$12, U$4.A1 (1), U$4.B1 (1); also elsewhere on the board
ADC1_CS: RPI_GPIO.22; also elsewhere on the board
ADC2_A4: TC_PT4_IN.P$4, TC_PT4_IN.P$10; also elsewhere on the board
ADC2_A5: TC_PT4_IN.P$3, TC_PT4_IN.P$9; also elsewhere on the board
ADC2_A6: TC_PT4_IN.P$2, TC_PT4_IN.P$8; also elsewhere on the board
ADC2_A7: TC_PT4_IN.P$1, TC_PT4_IN.P$7; also elsewhere on the board
ADC2_CS: RPI_GPIO.24; also elsewhere on the board
ADC3_CS: RPI_GPIO.26; also elsewhere on the board
CTRL_SOLENOID_1: RPI_GPIO.11; also elsewhere on the board
CTRL_SOLENOID_2: RPI_GPIO.13; also elsewhere on the board
CTRL_SOLENOID_3: RPI_GPIO.15; also elsewhere on the board
GND: RPI_GPIO.6, U$5.A2 (2), U$5.B2 (2); also elsewhere on the board
IGNITION_RELAY: RPI_GPIO.16; also elsewhere on the board
LC_1_OUT+: LC_IN1.P$3, LC_IN1.P$7; also elsewhere on the board
LC_1_OUT-: LC_IN1.P$4, LC_IN1.P$8; also elsewhere on the board
LC_2_OUT+: LC_IN1.P$1, LC_IN1.P$5; also elsewhere on the board
LC_2_OUT-: LC_IN1.P$2, LC_IN1.P$6; also elsewhere on the board
LC_3_OUT+: LC_IN2.P$3, LC_IN2.P$7; also elsewhere on the board
LC_3_OUT-: LC_IN2.P$4, LC_IN2.P$8; also elsewhere on the board
LC_4_OUT+: LC_IN2.P$1, LC_IN2.P$5; also elsewhere on the board
LC_4_OUT-: LC_IN2.P$2, LC_IN2.P$6; also elsewhere on the board
MISO: RPI_GPIO.21; also elsewhere on the board
MOSI: RPI_GPIO.19; also elsewhere on the board
PT1_VS-: PT_123_IN.P$5, PT_123_IN.P$11; also elsewhere on the board
PT2_VS-: PT_123_IN.P$3, PT_123_IN.P$9; also elsewhere on the board
PT3_VS-: PT_123_IN.P$1, PT_123_IN.P$7; also elsewhere on the board
PT4_VS-: TC_PT4_IN.P$5, TC_PT4_IN.P$11; also elsewhere on the board
RELAY_NEGATIVE: U$6.A1 (1), U$6.B1 (1); also elsewhere on the board
RPI_GPIO_1: RPI_GPIO.1
RPI_GPIO_3: RPI_GPIO.3
RPI_GPIO_4: RPI_GPIO.4
RPI_GPIO_5: RPI_GPIO.5
RPI_GPIO_7: RPI_GPIO.7
RPI_GPIO_8: RPI_GPIO.8
RPI_GPIO_9: RPI_GPIO.9
RPI_GPIO_10: RPI_GPIO.10
RPI_GPIO_12: RPI_GPIO.12
RPI_GPIO_14: RPI_GPIO.14
RPI_GPIO_17: RPI_GPIO.17
RPI_GPIO_18: RPI_GPIO.18
RPI_GPIO_20: RPI_GPIO.20
RPI_GPIO_25: RPI_GPIO.25
RPI_GPIO_27: RPI_GPIO.27
RPI_GPIO_28: RPI_GPIO.28
RPI_GPIO_29: RPI_GPIO.29
RPI_GPIO_30: RPI_GPIO.30
RPI_GPIO_31: RPI_GPIO.31
RPI_GPIO_32: RPI_GPIO.32
RPI_GPIO_33: RPI_GPIO.33
RPI_GPIO_34: RPI_GPIO.34
RPI_GPIO_35: RPI_GPIO.35
RPI_GPIO_36: RPI_GPIO.36
RPI_GPIO_37: RPI_GPIO.37
RPI_GPIO_38: RPI_GPIO.38
RPI_GPIO_39: RPI_GPIO.39
RPI_GPIO_40: RPI_GPIO.40
SCLK: RPI_GPIO.23; also elsewhere on the board
SOLENOID_1_NEGATIVE: U$6.A2 (2), U$6.B2 (2); also elsewhere on the board
SOLENOID_2_NEGATIVE: U$7.A1 (1), U$7.B1 (1); also elsewhere on the board
SOLENOID_3_NEGATIVE: U$7.A2 (2), U$7.B2 (2); also elsewhere on the board

Notes on the sheet:
RPI GPIO
External Signal Connectors
External Power Connectors
TODO: Figure out how to properly distinguish these on the hardware board?
TC_1
TC_2
TC_3
TC_4
DO NOT CONNECT

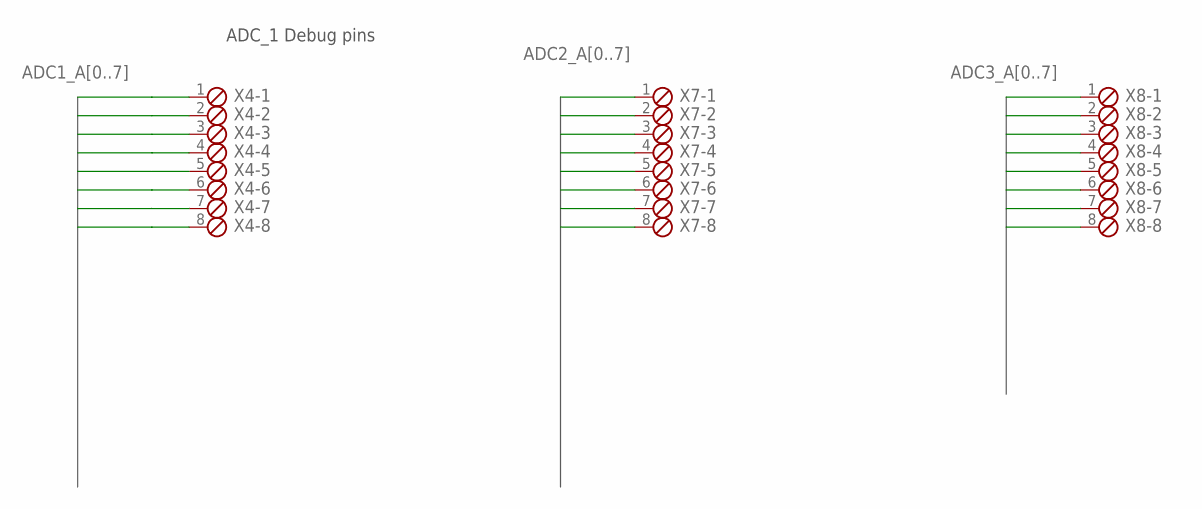
[picture p11: schematic main.sch, sheet 9, <b>Debug Pins</b><br> Used for debugging outputs.]

Parts:
X4, X7, X8: MPT8; 8POL254

Connections:
ADC1_A0: X4.1; also elsewhere on the board
ADC1_A1: X4.2; also elsewhere on the board
ADC1_A2: X4.3; also elsewhere on the board
ADC1_A3: X4.4; also elsewhere on the board
ADC1_A4: X4.5; also elsewhere on the board
ADC1_A5: X4.6; also elsewhere on the board
ADC1_A6: X4.7; also elsewhere on the board
ADC1_A7: X4.8; also elsewhere on the board
ADC2_A0: X7.1; also elsewhere on the board
ADC2_A1: X7.2; also elsewhere on the board
ADC2_A2: X7.3; also elsewhere on the board
ADC2_A3: X7.4; also elsewhere on the board
ADC2_A4: X7.5; also elsewhere on the board
ADC2_A5: X7.6; also elsewhere on the board
ADC2_A6: X7.7; also elsewhere on the board
ADC2_A7: X7.8; also elsewhere on the board
ADC3_A0: X8.1; also elsewhere on the board
ADC3_A1: X8.2; also elsewhere on the board
ADC3_A2: X8.3; also elsewhere on the board
ADC3_A3: X8.4; also elsewhere on the board
ADC3_A4: X8.5; also elsewhere on the board
ADC3_A5: X8.6; also elsewhere on the board
ADC3_A6: X8.7; also elsewhere on the board
ADC3_A7: X8.8; also elsewhere on the board

Notes on the sheet:
ADC_1 Debug pins
