rice-eclipse/rice-eclipse-mk1-1/eagle/rice-eclipse-mk-1-1/main.brd

## EAGLE design eagle/rice-eclipse-mk-1-1/main.brd (continued)

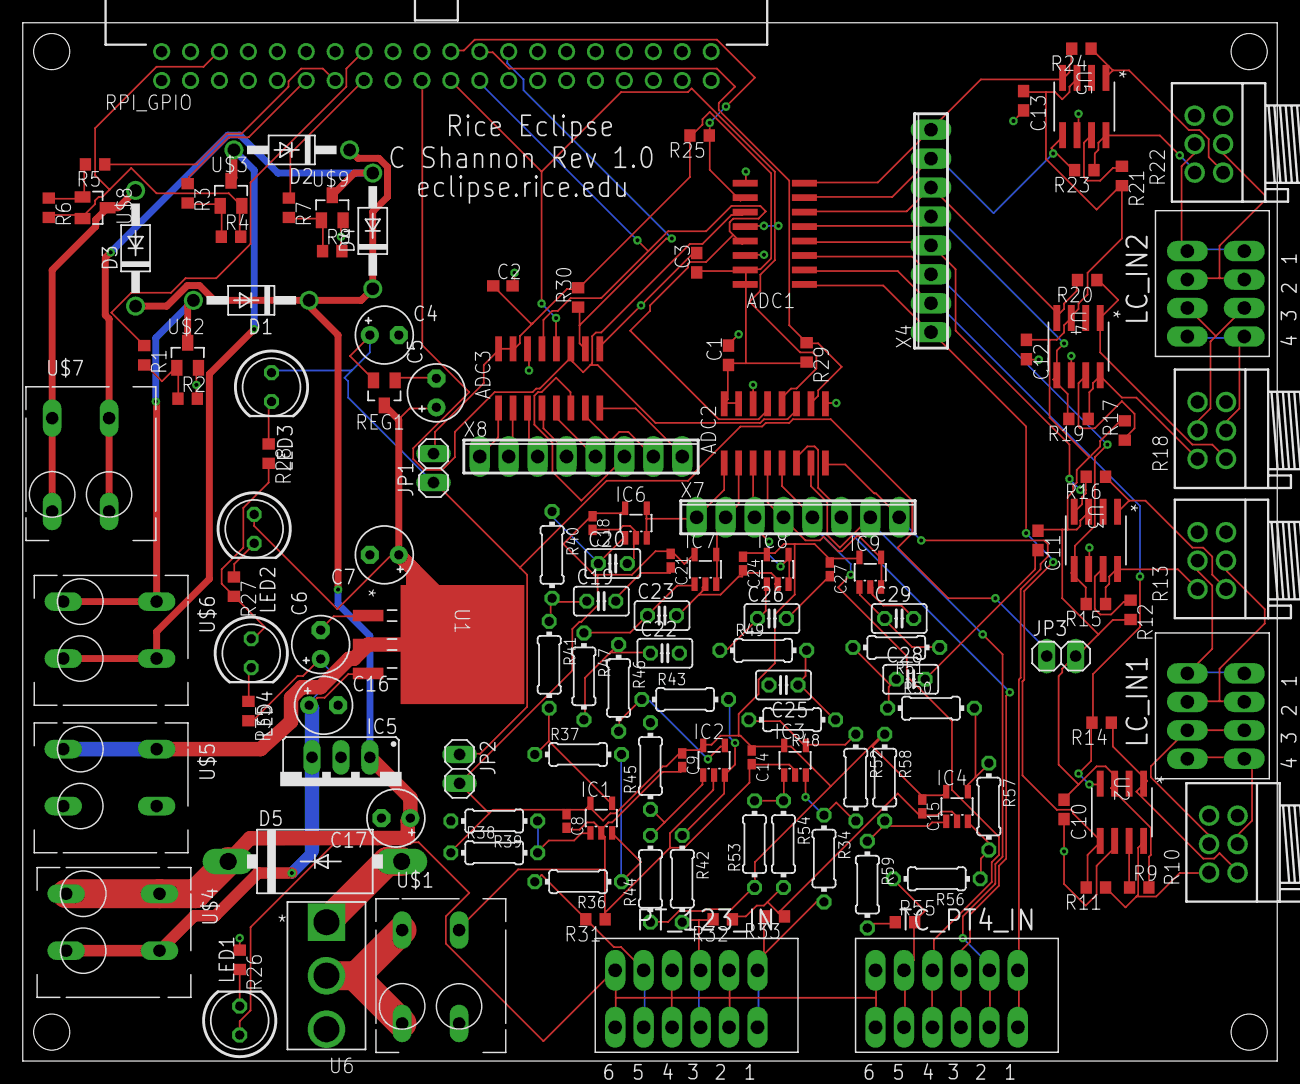
[picture p12: board main.brd from above]

Board: 2 copper layers, 110.2 x 91.2 mm, 136 parts (0 on the bottom side), 100 nets.
