rice-eclipse/rice-eclipse-mk1-1/software/src/final/pins.cpp

//
// Created by rjcunningham on 12/1/17.
//

#include <bcm2835.h>
#include "pins.hpp"

RPiGPIOPin ADC_0_CS = RPI_V2_GPIO_P1_26;
RPiGPIOPin ADC_1_CS = RPI_V2_GPIO_P1_24;
RPiGPIOPin ADC_2_CS = RPI_V2_GPIO_P1_22;

RPiGPIOPin MAIN_VALVE = RPI_V2_GPIO_P1_11;
RPiGPIOPin VALVE_2 =RPI_V2_GPIO_P1_13;
RPiGPIOPin VALVE_3 = RPI_V2_GPIO_P1_15;
RPiGPIOPin IGN_START = RPI_V2_GPIO_P1_16;

RPiGPIOPin LC_ADC = ADC_0_CS;
RPiGPIOPin PT_ADC = ADC_1_CS;
RPiGPIOPin TC_ADC = ADC_1_CS;
