rice-eclipse/rice-eclipse-mk1-1/mk1_gui/gui_timstamp.py

# right now only one plot is gonna be displayed; just add more if necessary


import socket
import threading
from queue import Queue
import serial
import matplotlib

matplotlib.use("TKAgg")
import tkinter as tk
from tkinter import ttk
from matplotlib.backends.backend_tkagg import FigureCanvasTkAgg, NavigationToolbar2TkAgg
from matplotlib.figure import Figure
import matplotlib.animation as animation
from  matplotlib import style

s = socket.socket()

# make it configurable in the gui (text input box and button)


# data buffer
queue1 = Queue()
x_index = Queue()
x_index.put(0)

# plot style
style.use("dark_background")

# configure the plot
f = Figure(figsize=(5, 5), dpi=100)
a = f.add_subplot(111)
xlist = []
ylist = []


def lshift(lst, number):
    for i in range(0, len(lst)):
        if i < len(lst) - number:
            lst[i] = lst[i + number]
        else:
            lst[i] = 0


# animation for live plot
def animate(i):
    # could make it update a whole chunck of data instead
    n = 400
    m = 2000
    if queue1.qsize() >= n:

        if len(ylist) >= m:
            lshift(ylist, n)
            lshift(xlist, n)
            for i in range(0, n):
                first_byte = queue1.get()
                # second_byte = queue1.get()
                pullData = int.from_bytes(first_byte, byteorder="big", signed=True)
                ylist[m - n + i] = pullData

                second_bytes=queue1.get()
                timestamp=int.from_bytes(second_bytes, byteorder="big", signed=True)
                # index = x_index.get()
                xlist[m - n + i] = timestamp
                # index = index + 1
                # x_index.put(index)
        else:
            for i in range(0, n):
                first_byte = queue1.get()
                # second_byte = queue1.get()
                pullData = int.from_bytes(first_byte, byteorder="big", signed=True)
                ylist.append(pullData)

                second_bytes=queue1.get()
                timestamp=int.from_bytes(second_bytes, byteorder="big", signed=True)
                # index = x_index.get()
                xlist.append(timestamp)
                # index = index + 1
                # x_index.put(index)
        # could timestamp instead

        a.clear()
        a.plot(xlist, ylist)
    else:
        a.plot(xlist, ylist)


# called serialread, actually socket read though. rename if you want (be sure to change the name in other locations)
def serialread(s, q):
    while 1:
        data = s.recv(8)
        data1= s.recv(8)
        if len(data) != 0 and len(data1) != 0:
            q.put(data)
            q.put(data1)


# thread for data acquisition
class myThread1(threading.Thread):
    def __init__(self, threadID, name, counter):
        threading.Thread.__init__(self)
        self.threadID = threadID
        self.name = name
        self.counter = counter

    def run(self):
        serialread(s, queue1)


# gui set up
class gui(tk.Tk):
    def __init__(self, *args, **kwargs):
        tk.Tk.__init__(self, *args, **kwargs)

        frame1 = tk.Frame(self)
        frame1.pack(side="top", fill="both", expand=True)
        frame1.grid_rowconfigure(0, weight=1)
        frame1.grid_columnconfigure(0, weight=1)

        self.frames = {}
        frame = StartPage(frame1, self)
        self.frames[StartPage] = frame
        frame.grid(row=0, column=0, sticky="nesw")
        self.show_frame(StartPage)

    def run(self):
        # self.frames[StartPage].updateGui()
        self.mainloop()

    def show_frame(self, cont):
        frame = self.frames[cont]
        frame.tkraise()


# function to connect the socket
def connect_socket(host, port):
    s.connect((host, int(port)))
    start_listen()


# test function for sending via socket
def test(entry):
    s.send(str.encode(entry))
    s.send(str.encode("\n"))


def start_listen():
    thread1 = myThread1(1, "Thread-1", 1)
    thread1.start()


# startpage
class StartPage(tk.Frame):
    def __init__(self, parent, controller):
        tk.Frame.__init__(self, parent)
        label1 = tk.Label(self, text="IP")
        label1.grid(row=0, column=10)
        entry2 = tk.Entry(self)
        entry2.grid(row=0, column=11)

        label2 = tk.Label(self, text="port")
        label2.grid(row=1, column=10)
        entry3 = tk.Entry(self)
        entry3.grid(row=1, column=11)
        button4 = tk.Button(self, text="Connect", command=lambda: connect_socket(entry2.get(), entry3.get()))
        button4.grid(row=1, column=12)
        # button5 = tk.Button(self, text="Plot", command=lambda:start_listen())
        # button5.grid(row=2,column=12)
        # more buttons can be added,as well as text boxes
        # the third arguement is gonna be the function the button need to bind
        button1 = tk.Button(self, text="Button1")
        button2 = tk.Button(self, text="Button2")
        button3 = tk.Button(self, text="Button3", command=lambda: test(entry1.get()))
        button1.grid(row=100, column=10)
        button2.grid(row=100, column=11)
        button3.grid(row=100, column=12)
        entry1 = tk.Entry(self)
        entry1.grid(row=101, column=11)

        # potential for multipage gui
        self.controller = controller

        canvas = FigureCanvasTkAgg(f, self)
        canvas.show()
        canvas.get_tk_widget().grid(row=3, column=10, columnspan=3, rowspan=1, padx=5, pady=5, sticky="WENS")


        # don't actually need it right now
        # def updateGui(self):
        #     if queue1.qsize() >= 2:
        #         first_byte = queue1.get()
        #         second_byte = queue1.get()
        #
        #         final_num = int.from_bytes(second_byte+first_byte, byteorder="big",signed=True)
        #         self.controller.lbl["text"] = final_num
        #         self.controller.update()
        #         self.controller.lbl.after(1000, self.updateGui)
        #     else:
        #         self.controller.lbl.after(1000, self.updateGui)


gui1 = gui()

# put the thread run in a button binded function in order to control when it would run

ani = animation.FuncAnimation(f, animate, interval=25)

gui1.run()
