rice-eclipse/rice-eclipse-mk1-1/(commit log)

2017-08-24 Added the eagle files and configured them for proper use. Added an empty software folder for now.
    [main.sch]
2017-08-25 Added a new library for our 3.3V regulator. Fixed library backups in eagle .gitignore.
2017-08-31 Added some new voltage regulators and used them. I also did something else, but I'm not sure what it was.
    [main.sch]
2017-09-02 Added a shorts library and some skeleton sheets in the schematic. Should provide a good environment for working on project.
    [main.sch]
2017-09-03 Added voltage regulator for -0.23v
    [main.sch]
2017-09-04 edited wire
    [main.sch]
2017-09-08 Added an echo_server test for the pi. Currently listens on port 1234.
    Some stuff not well set up, but that's to be expected.
2017-09-08 Added example spi code.
2017-09-09 Added relay and solenoid driver stuff
    [main.sch]
2017-09-09 Added a new sheet for external connectors.
    Added raspberry PI GPIO to the sheet.
    Will probably add any outputs and inputs soon.
    [main.sch]
2017-09-09 Tweaked name of a wire.
    [main.sch]
2017-09-11 Added a bunch of libraries to eagle and added some stuff.
    Fixed double pins on phoenix 500 library item.
    Added signal connectors to eagle libs.
    Added op-amp to texas lib.
    Added some headers to listener.
    [main.sch]
2017-09-14 Added external connectors and basic load cell amp.
    [main.sch]
2017-09-14 Added spi build target and fixed cpp compiler warning.
    [spi.cpp]
2017-09-21 Created a new build target for an adc abstraction.
2017-09-25 Wrote jank code for adc_block.cpp. The read_item method is adapted from spi.cpp. The other methods are non-empty but might not be what we want.
2017-09-28 Thursday 9/28. Testing adc.cpp
2017-09-28 Thursday 9/28. Testing adc.cpp. Forgot some stuff in the previous push.
2017-09-28 Thursday 9/28. Testing adc.cpp. Testing on Pi
2017-09-30 finished load cell circuit copied it over
    ya
    [main.sch]
2017-10-04 Merged in some code from the pi server branch.
    Also fixed a bug in the echo server.
    [gui_integrate.py, main.cpp]
2017-10-05 Made a threaded adc test thingy.
2017-10-06 Timestamp support for the adc test.
2017-10-07 rotated capacitors
    [main.brd, main.sch]
2017-10-08 Determined the issue with the circular buffer giving garbage.
    Caused by padding of the adc_reading struct to a larger size.
    Best course of action is to leave it like this because it provides
    fine performance at little to no actual cost.
    [circular_buffer_test.cpp]
2017-10-11 Cleaned up placement on the board. Router scares me.
    [main.brd, main.sch]
2017-10-12 Added a new 4-pin signal connector. Also modified board.
    [main.brd, main.sch]
2017-10-12 Added RPI GPIO connections.
    [main.brd, main.sch]
2017-10-15 EAGLE stuff
    - changed 6 pin connectors to 4 pin for loadcells 1-4
    - deleted load cell 5 connector
    - added debugging slide switches
    - board rearranged
    [main.brd, main.sch]
2017-10-15 Eagle Stuff
    changed 5v_debug to 5v
    [main.sch]
2017-10-21 Added test LEDs for schematic.
    LEDs allow for test of current.
    [main.sch]
2017-10-21 Deleted LEDS to resync board
    [main.sch]
2017-10-21 Added new libraries and fixed board annotation.
    LEDS had to be removed in the process. Will re-add in next
    version. I'm mostly just happy that the board is fixed.
    [main.brd, main.sch]
2017-10-22 Added to the LEDs
    [main.brd, main.sch]
2017-10-22 Cleaned up the board, added adcs, debug pins.
    [main.brd, main.sch]
2017-10-22 Added more board parts.
    [main.brd, main.sch]
2017-10-26 Added initial PT circuit guess and
    added some routes for power.
    [main.brd, main.sch]
2017-10-26 Slightly increased size of power traces.
    [main.brd]
2017-10-29 Made a bunch of stuff.
    [main.brd, main.sch]
2017-10-29 Added flyback diodes and moved stuff onto board.
    [main.brd, main.sch]
2017-10-29 Added schottky diode.
    [main.brd, main.sch]
2017-10-29 Added some stuff.
    [main.brd, main.sch]
2017-10-29 Board is ready to route.
    [main.brd, main.sch]
2017-10-29 Routed power traces. Autorouter starts next.
    [main.brd]
2017-10-30 Routed and messed with text.
    [main.brd, main.sch]
2017-10-30 Routed and tried to gen board.
    Fixed cap sizes too.
    [main.brd, main.sch]
2017-11-11 Some updates to circ buff usage.
    Fixed bug for fancy server operation.
    Next step is to completely reorganize the project layout in other branch.
    [threaded_circular_buffer_test.cpp]
2017-11-19 Added sideboard.
    [sideboard.brd, sideboard.sch]
2017-11-19 Added and routed.
    [sideboard.brd]
2017-11-19 Rerouted with more stuff.
    [sideboard.brd, sideboard.sch]
2017-11-28 Fixed code for board to pull GPIO 22 high, which is connected to the CS pin for a third ADC, which we would like to disable.
    [spi.cpp]
2017-11-30 Wrote a bunch of new networking code that is probably broken.
    [gui_timstamp.py, initialization.cpp, initialization.hpp, main.cpp, main_network_worker.cpp, main_network_worker.hpp]
2017-12-01 GUI code rewrite in progress. Hopefully easier for me to use. Currently the queue stuff is still really broken.
    [gui_final.py, networking.py, server_info.py]
2017-12-01 GUI networking is yet again more robust. Still has no good way of signaling that we've lost connection or trying to reconnect, but that's a problem for another day.
    [gui_final.py, networking.py]
2017-12-01 GUI networking somewhat broken when receiving messages. Will add some helpful debug logging and then I'll look into the issue.
    [gui_final.py, gui_integrate.py, networking.py, server_info.py]
2017-12-01 Fixed some stupid byte alignment bullshit.
    [concurrency.py, gui_final.py, logger.py, networking.py, server_info.py]
2017-12-01 Things are going pretty well. A couple more steps to maybe get things working.
2017-12-01 Verified counter and plotting working well.
    Some major problem where it seems to print a value that's too large.
    That's something I'll investigate.
2017-12-01 Fixed network worker code to compile correctly.
    [main_network_worker.cpp]
2017-12-01 I think the reading is now correct pending a concurrency issue with the python gui where the animate method can't get a lock.
    [gui_final.py, gui_integrate.py, networking.py, server_info.py]
2017-12-01 Cleaned counter worker
    Fixed compiler error in main network worker
    Added extra include to pi so we can use offsetof.
    Fixed some major bugs with circular buffer.
    [main_network_worker.cpp]
2017-12-02 Fixed some timing issues.
    [gui_final.py, networking.py, pins.hpp, server_info.py]
2017-12-02 Made start of final setup + threaded adc test into new format.
    Took forever to fix compiler problems.
    [initialization.cpp, initialization.hpp, main.cpp, main_network_worker.cpp, main_network_worker.hpp, main_worker.cpp, main_worker.hpp]
2017-12-02 Fixed some adc block errors.
    Verified the ADC looping code works.
    [main.cpp, main_network_worker.hpp]
2017-12-02 Wrote some simple output switching code.
2017-12-02 Modified main worker. Realized I had done stuff wrong.
    [main_worker.cpp]
2017-12-02 Added some stuff: logging in Plotter, buttons for calibrate/valve actuation/disconnect, Jeremy's nut button, and more plots.
2017-12-02 Fixed some initialization code.
    [initialization.cpp, initialization.hpp, main.cpp]
2017-12-02 I think. I hope the ADC code will work and everything will be fine.
2017-12-02 Fixed the timed ignition with hardcoded values. Please kill me.
    [main_worker.cpp]
2017-12-02 Bashing down a couple bugs in adc running code. Still in progress.
    [main_worker.cpp]
2017-12-02 Added some more stuff to fix issues.
    [main_worker.cpp, main_worker.hpp]
2017-12-02 Added handling for separate payloads. Need to change button locations.
2017-12-22 GUI is less ugly and code is shorter. Added a way to specify amount of data to graph.
    [gui_final.py, sampleCode.py, server_info.py]
2017-12-24 Removed some profanity and clarified a couple documentation pieces.
2017-12-28 Added some more buttons and cosmetic improvements. I'm disabling animation for now while I work on adding the ability to change graphs through the GUI.
2017-12-28 Changing graphs seems to work for random data, but there will probably be bugs when we try to test it with real data.
    [graph_constants.py, gui_final.py, sampleCode.py]
2017-12-30 Fixed a bug that affected axes autoscaling.
    [gui_final.py]
2018-01-20 Removed some profanity and clarified a couple documentation pieces. Also added a start of a logger, but I doubt it works or even compiles.
