rice-eclipse/rice-eclipse-mk1-1/(notices)

Notices in the files:
parts and their libraries:
SLIDE_SW: COPYRIGHT: Copyright (C) 2015 Accelerated Designs. All rights reserved
